alexbubbles/embedded-otp-access-system/README.md

# Bare-Metal AVR Dual-Factor Access Control System (PIN + OTP)
